HuyNQct/Techfine_STE-solar-inverter-dashboard-using-esp32/frontend/src/assets/images/nen.jpg

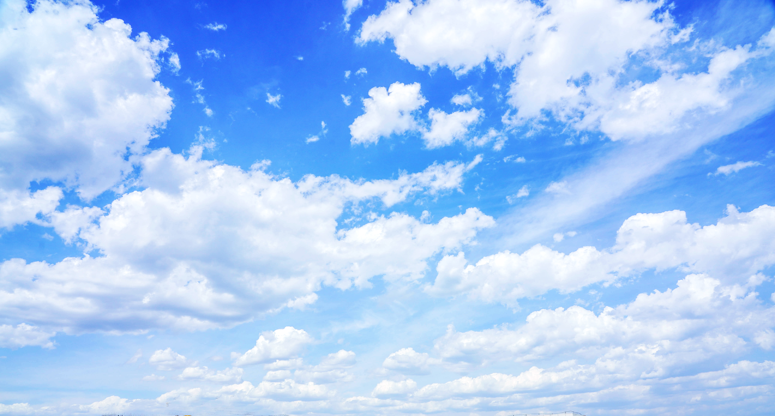
frontend/src/assets/images/nen.jpg
